seadogger/ArduinoFlatBox/(commit log)

2020-12-06 Modified to work with servo motors
2020-12-09 Added switch to turn on/off servo motor
2021-03-08 Arduino sketch update
2022-05-23 Updates to support EL Panel and 5V
2022-05-23 Upload Pictures of 3D Printer Parts
